halfmer/XIH6-Thermal-Camera/Lepton驱动参考/hardware/LeptonMicroBreakout/PureThermal_Micro_BoB.step

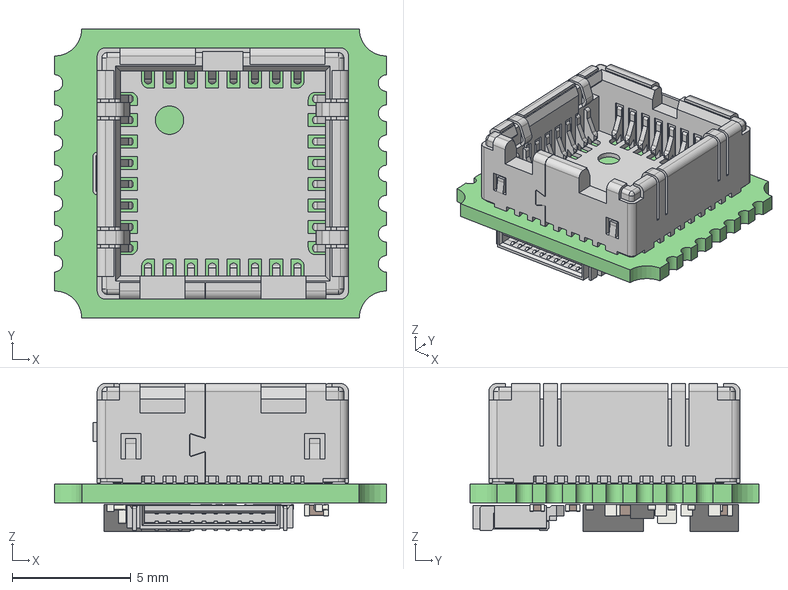
[picture p7: CAD file, 2026-07-07]
Lepton驱动参考/hardware/LeptonMicroBreakout/PureThermal_Micro_BoB.step
14.0 x 12.2 x 6.25 mm
_autosave-PureThermal_BoB_Mini PCB
