halfmer/XIH6-Thermal-Camera/MDK-ARM/build_log.txt

*** Using Compiler 'V6.24', folder: 'E:\keil_v5\ARM\ARMCLANG\Bin'
Build target 'XIH6_V2'
compiling main.c...
compiling lepton.c...
linking...
Program Size: Code=66718 RO-data=8478 RW-data=40 ZI-data=54088  
FromELF: creating hex file...
"XIH6_V2\XIH6_V2.axf" - 0 Error(s), 0 Warning(s).
Build Time Elapsed:  00:00:02
