halfmer/XIH6-Thermal-Camera/Core/Src/main.c

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
/* Includes ------------------------------------------------------------------*/
#include "main.h"
#include "adc.h"
#include "dma.h"
#include "i2c.h"
#include "ltdc.h"
#include "sdmmc.h"
#include "spi.h"
#include "usart.h"
#include "gpio.h"

/* USER CODE BEGIN Includes */
#include "LED.h"
#include "DELAY.h"
#include "oled.h"
#include "SHT40.h"
#include "SD_Card.h"
#include "string.h"
#include "lepton.h"
#include "lepton_stream.h"
#include "fire_guard.h"

/* USER CODE END Includes */

/* USER CODE BEGIN PTD */
/* Background time-wheel entry: period-gated cooperative task. The video
   path deliberately stays OUT of the wheel (README_14 §3). */
typedef struct {
    uint32_t period_ms;
    uint32_t last;
    void   (*fn)(void);
} App_WheelTask_t;
/* USER CODE END PTD */

/* USER CODE BEGIN PD */
#define SD_TEST_SECTOR   0x10000UL   /* scratch LBA used by the R/W self-test */
/* USER CODE END PD */


/* USER CODE BEGIN PV */
float temperature = 0.0f;
float humidity = 0.0f;
uint8_t sht40_status = 0;
char disp_buff[32]; //

/* SD card state */
uint8_t sd_init_status = SD_NOT_PRESENT;
uint8_t sd_present_last = 0xFF;          /* 0xFF forces a first-pass refresh */
HAL_SD_CardInfoTypeDef sd_info;
/* USER CODE END PV */

void SystemClock_Config(void);
void PeriphCommonClock_Config(void);
static void MPU_Config(void);
/* USER CODE BEGIN PFP */
static void SD_UART_Print(const char *s);
static void SD_ReportStatus(void);
static uint8_t SD_SelfTest(uint32_t sector);
static void LEP_PrintVoSPIDiag(const char *tag);
static void App_Task_Fire(void);
static void App_Task_Oled(void);
static void App_Task_Sht40(void);
static void App_Task_SdCd(void);
/* USER CODE END PFP */

/* USER CODE BEGIN 0 */
    unsigned char s_buf[]="It's mygo!!!!!\r\n";

static void LEP_PrintVoSPIDiag(const char *tag)
{
    char vd[448];

    sprintf(vd, "[LEP] VoSPI %s reason=%u reads=%lu valid=%lu discard=%lu invalid=%lu pkt0=%lu desync=%lu badseg=%lu spierr=%lu stale=%u mask=0x%02X seen=%u/%u/%u/%u segs=%u/%u/%u/%u dup=%u bad0=%u badx=%u wait=%u exp=%u last=%02X %02X %02X %02X seg=0x%02X\r\n",
            tag,
            (unsigned)lepton_diag.vospi_fail_reason,
            (unsigned long)lepton_diag.vospi_reads,
            (unsigned long)lepton_diag.vospi_valid,
            (unsigned long)lepton_diag.vospi_discard,
            (unsigned long)lepton_diag.vospi_invalid,
            (unsigned long)lepton_diag.vospi_pkt0,
            (unsigned long)lepton_diag.vospi_desync,
            (unsigned long)lepton_diag.vospi_bad_seg,
            (unsigned long)lepton_diag.vospi_spi_err,
            (unsigned)lepton_diag.vospi_stale_block,
            (unsigned)lepton_diag.vospi_got_mask,
            (unsigned)lepton_diag.vospi_seg_seen[1],
            (unsigned)lepton_diag.vospi_seg_seen[2],
            (unsigned)lepton_diag.vospi_seg_seen[3],
            (unsigned)lepton_diag.vospi_seg_seen[4],
            (unsigned)lepton_diag.vospi_seg_ok[1],
            (unsigned)lepton_diag.vospi_seg_ok[2],
            (unsigned)lepton_diag.vospi_seg_ok[3],
            (unsigned)lepton_diag.vospi_seg_ok[4],
            (unsigned)lepton_diag.vospi_dup_seg,
            (unsigned)lepton_diag.vospi_seg_bad0,
            (unsigned)lepton_diag.vospi_seg_badx,
            (unsigned)lepton_diag.vospi_sync_waits,
            (unsigned)lepton_diag.vospi_last_expected,
            (unsigned)lepton_diag.vospi_last_id0,
            (unsigned)lepton_diag.vospi_last_id1,
            (unsigned)lepton_diag.vospi_last_crc0,
            (unsigned)lepton_diag.vospi_last_crc1,
            (unsigned)lepton_diag.vospi_last_seg);
    SD_UART_Print(vd);
}
/* USER CODE END 0 */

/**
  * @brief  The application entry point.
  * @retval int
  */
int main(void)
{

  /* USER CODE BEGIN 1 */
  uint32_t test_count = 0;
  /* USER CODE END 1 */

  /* MPU Configuration--------------------------------------------------------*/
  MPU_Config();

  /* MCU Configuration--------------------------------------------------------*/

  /* Reset of all peripherals, Initializes the Flash interface and the Systick. */
  HAL_Init();

  /* Configure the system clock */
  SystemClock_Config();

  /* Configure the peripherals common clocks */
  PeriphCommonClock_Config();

  /* Initialize all configured peripherals */
  MX_GPIO_Init();
  MX_DMA_Init();
  MX_USART1_UART_Init();
  MX_SDMMC2_SD_Init();
  MX_I2C4_Init();
  MX_SPI4_Init();
  MX_ADC1_Init();
  MX_ADC2_Init();
  MX_LTDC_Init();
  MX_SPI5_Init();
  MX_UART4_Init();
  MX_UART5_Init();
  /* USER CODE BEGIN 2 */
  /* CH340C link (UART4 @ PA0/PA1, TX/RX swapped in CR2) -> 1.5Mbps.
     Carries only the binary thermal stream; host sends 'S'/'P'. */
  Lepton_Stream_Init(&huart4);

  /* Buzzer silent on request. New HW: PG9 -> 1k -> NPN base (10k base-emitter),
     emitter=GND, collector=buzzer(-), buzzer(+)=VCC. Active-HIGH low-side drive:
     PG9 HIGH = transistor ON = sound; PG9 LOW = OFF = silent. */
  HAL_GPIO_WritePin(BEEP_GPIO_GPIO_Port, BEEP_GPIO_Pin, GPIO_PIN_RESET);

  SW_I2C_Init();
  OLED_Init();

  OLED_Clear();
  OLED_ShowString(0, 0, (uint8_t *)"G:----- A:-----   ", 12, 1);

  OLED_ShowString(0, 16, (uint8_t *)"Temp: ", 16, 1);
  OLED_ShowString(0, 32, (uint8_t *)"Humi: ", 16, 1);

  FireGuard_Init();


  HAL_UART_Transmit(&huart1, s_buf, (uint16_t)strlen((char *)s_buf), 100);

  /* ---- Reset-cause banner. If inserting the SD card makes THIS line re-print
     with POR/BOR/PIN set, the "freeze" is really a brownout/reset on insertion
     (a power-integrity hardware fault), NOT a software hang in HAL_SD_Init. ---- */
  {
      char rb[96];
      uint32_t rsr = RCC->RSR;
      sprintf(rb, "\r\n[RST] RSR=0x%08lX POR=%u BOR=%u PIN=%u SFT=%u IWDG=%u LPWR=%u\r\n",
              (unsigned long)rsr,
              (unsigned)((rsr >> 23) & 1U),   /* PORRSTF  */
              (unsigned)((rsr >> 21) & 1U),   /* BORRSTF  */
              (unsigned)((rsr >> 22) & 1U),   /* PINRSTF  */
              (unsigned)((rsr >> 24) & 1U),   /* SFTRSTF  */
              (unsigned)((rsr >> 26) & 1U),   /* IWDG1RSTF*/
              (unsigned)((rsr >> 30) & 1U));  /* LPWRRSTF */
      HAL_UART_Transmit(&huart1, (uint8_t *)rb, (uint16_t)strlen(rb), 100);
      __HAL_RCC_CLEAR_RESET_FLAGS();
  }

  SD_UART_Print("[STREAM] UART4/CH340 1.5Mbps binary only: 'S' = start thermal stream, 'P' = stop; debug logs on USART1 @115200\r\n");

  /* ---- SD card bring-up + read/write self-test ---- */
  if (SD_IsPresent() != SD_OK)
  {
      sd_present_last = 0;
      sd_init_status  = SD_NOT_PRESENT;
      OLED_ShowString(32, 48, (uint8_t *)"No Card ", 16, 1);
      SD_UART_Print("\r\n[SD] no card in slot\r\n");
  }
  else
  {
      sd_present_last = 1;
      sd_init_status  = SD_Card_Init();
      SD_ReportStatus();
      if (sd_init_status == SD_OK)
      {
          if (SD_SelfTest(SD_TEST_SECTOR) == SD_OK)
              SD_UART_Print("[SD] R/W self-test PASS\r\n");
          else
              SD_UART_Print("[SD] R/W self-test FAIL\r\n");
      }
  }

  /* ---- Lepton 3.5 thermal camera bring-up (VoSPI@SPI4, CCI@I2C4) ----
     Reconfigures PA8 as TIM1_CH1 ~24MHz and SPI4 (mode 3/8-bit/7.5MHz/soft-CS on PE4).
     Releases RESET_L(PJ3)/PWR_DWN_L(PH6) (CubeMX holds them asserted at boot),
     waits ~950ms boot, then enables radiometric TLinear over CCI. */
  Lepton_Init(&hspi4, &hi2c4);
  {
      char lbuf[320];
      char cci_boot = lepton_diag.last_i2c_ok ? (lepton_diag.booted ? '1' : '0') : '?';
      sprintf(lbuf, "[LEP] mclk=%u mclk_hz=%lu sys=%lu pclk2=%lu pwr=%u rst=%u rstIDR=%u pwdnIDR=%u i2c_rdy=%u cci=%s cci_boot=%c(%lums) status_ok=%u status=0x%04X tlin=%d\r\n",
              (unsigned)lepton_diag.mclk_on,
              (unsigned long)lepton_diag.mclk_hz,
              (unsigned long)lepton_diag.sysclk_hz,
              (unsigned long)lepton_diag.pclk2_hz,
              (unsigned)lepton_diag.powered,
              (unsigned)lepton_diag.reset_released, (unsigned)lepton_diag.rst_readback,
              (unsigned)lepton_diag.pwdn_readback, (unsigned)lepton_diag.i2c_ready,
              lepton_diag.cci_transport ? "BB" : "HAL",
              cci_boot, (unsigned long)lepton_diag.boot_wait_ms,
              (unsigned)lepton_diag.last_i2c_ok, (unsigned)lepton_diag.status_reg,
              (int)lepton_diag.tlinear_err);
      SD_UART_Print(lbuf);
      if (!lepton_diag.rst_readback)
          SD_UART_Print("[LEP] RESET_L(PJ3) reads LOW after release -> net held low (short/pulldown/HW), Lepton stuck in reset\r\n");
      else if (!lepton_diag.i2c_ready)
      {
          char ib[200];
          sprintf(ib, "[LEP] HAL I2C4 no ACK @0x2A: err=0x%lX isr=0x%lX SCLidle=%u SDAidle=%u scan_first=0x%02X scan_cnt=%u\r\n",
                  (unsigned long)lepton_diag.i2c_err, (unsigned long)lepton_diag.i2c_isr,
                  (unsigned)lepton_diag.scl_idle, (unsigned)lepton_diag.sda_idle,
                  (unsigned)lepton_diag.i2c_scan_first, (unsigned)lepton_diag.i2c_scan_count);
          SD_UART_Print(ib);
          if (!lepton_diag.last_i2c_ok)
              SD_UART_Print("[LEP] CCI status unread -> cci_boot is UNKNOWN; shutter/FFC motion still means the Lepton core likely booted\r\n");
          if (!lepton_diag.scl_idle || !lepton_diag.sda_idle)
              SD_UART_Print("[LEP] I2C line STUCK LOW at idle -> no pull-up / short to GND / VDDIO off / wrong pin. Fix wiring first.\r\n");
          else if (lepton_diag.i2c_scan_count == 0)
              /* NOTE: HAL_I2C_IsDeviceReady returns err=0x20(TIMEOUT) for a plain
                 no-ACK too (it clears AF each trial and ORs TIMEOUT at the end), so
                 0x20 alone does NOT prove a clock/peripheral fault. Lines idle-high
                 + 0 devices = nobody answers on an electrically-OK bus. The bit-bang
                 result below is the decisive config-vs-hardware test. */
              SD_UART_Print("[LEP] lines high but 0 devices -> see bit-bang test below (Lepton VDDIO 2.8V? pull-ups? SDA/SCL swap?)\r\n");
          else if (lepton_diag.i2c_scan_first != 0x2A)
              SD_UART_Print("[LEP] I2C alive but Lepton not at 0x2A -> likely SDA/SCL swapped or wrong module pins\r\n");

          /* DECISIVE config-vs-hardware test: SW_I2C-style open-drain GPIO on
             PD12/PD13, bypassing the STM32 I2C4 peripheral entirely. */
          {
              char bb[192];
              sprintf(bb, "[LEP] SW-OD I2C (SW_I2C-style, bypasses I2C4): ack@0x2A=%u scan_first=0x%02X scan_cnt=%u\r\n",
                      (unsigned)lepton_diag.bb_ack_2a,
                      (unsigned)lepton_diag.bb_scan_first,
                      (unsigned)lepton_diag.bb_scan_count);
              SD_UART_Print(bb);

              /* Second bit-bang pass with SCL/SDA roles SWAPPED (SCL=PD13,
                 SDA=PD12). If this pass ACKs where the normal pass did not, the
                 two lines are physically swapped -> just re-wire, no scope. */
              {
                  char sw[160];
                  sprintf(sw, "[LEP] bit-bang SWAPPED (SCL=PD13,SDA=PD12): ack@0x2A=%u scan_first=0x%02X scan_cnt=%u\r\n",
                          (unsigned)lepton_diag.bb_swap_ack,
                          (unsigned)lepton_diag.bb_swap_first,
                          (unsigned)lepton_diag.bb_swap_count);
                  SD_UART_Print(sw);
              }

              if (lepton_diag.bb_ack_2a)
                  SD_UART_Print("[LEP] >>> bit-bang ACKs @0x2A but HAL did NOT -> using software CCI fallback; I2C4 timing/config remains suspect\r\n");
              else if (lepton_diag.bb_swap_ack)
                  SD_UART_Print("[LEP] >>> SWAPPED pass ACKs @0x2A -> SDA/SCL ARE PHYSICALLY SWAPPED. Swap PD12<->PD13 wiring.\r\n");
              else if (lepton_diag.bb_scan_count > 0 || lepton_diag.bb_swap_count > 0)
                  SD_UART_Print("[LEP] >>> bit-bang finds device NOT at 0x2A -> wrong address / partial swap (HW alive)\r\n");
              else
                  SD_UART_Print("[LEP] >>> normal+swapped bit-bang both 0 devices -> not an I2C4 peripheral issue; check CCI pad power/level/timing or module state\r\n");
          }
      }
      else if (!lepton_diag.last_i2c_ok)
          SD_UART_Print("[LEP] I2C ACKed once but STATUS read failed -> CCI register phase/timing still suspect\r\n");
      else if (!lepton_diag.booted)
          SD_UART_Print("[LEP] CCI STATUS readable but boot bit is 0 -> check MCLK ~24MHz clean / reset timing\r\n");
  }
  /* USER CODE END 2 */

  /* Infinite loop */
  /* USER CODE BEGIN WHILE */
  while (1)
  {
    /* USER CODE END WHILE */

    /* USER CODE BEGIN 3 */

    /* --------------------------------------------------------------------
     * Cooperative super-loop ("pseudo-concurrent", no RTOS):
     *   - the LEPTON video pipeline runs every iteration (stream mode) or
     *     on its idle test cadence;
     *   - every other peripheral gets a tick-gated SLICE that runs in BOTH
     *     modes. Each slice is short (µs..10ms) and touches only its own
     *     peripheral, so nothing can starve or corrupt the video path.
     *   Red line: no USART1 prints from slices while a TX DMA may be in
     *   flight (README_9 Step9A) - slices below only use OLED (SW_I2C),
     *   ADC1/2 and GPIO, none of which are shared with the stream.
     * ------------------------------------------------------------------ */

    Lepton_Stream_Poll();

    /* ---- slice 0: LEPTON video (the priority customer) ---- */
    if (Lepton_Stream_Active())
    {
        if (Lepton_Capture_Frame())
        {
            Lepton_Stream_SendFrame();
            /* scan AFTER arming the TX DMA: the ~100µs hot-spot sweep runs
               in parallel with the transfer, video latency unchanged */
            FireGuard_ThermalScan();
        }
        else
            Lepton_VoSPI_Resync();
        LED_TURN(1);              /* 2ms heartbeat vs ~256ms per frame */
    }
    else
    {
        LED_TURN(250);
        test_count++;

        /* idle-mode Lepton health check every ~16 loops (~8s) */
        if ((test_count % 16U) == 0U)
        {
            if (Lepton_Capture_Frame())
            {
                char lp[48];
                uint16_t craw = lepton_raw_frame[60][80];   /* centre pixel */
                float    ctmp = Lepton_Raw_To_Temp(craw);
                FireGuard_ThermalScan();   /* idle mode: 8s cadence, still guarded */
                sprintf(lp, "[LEP] OK c_raw=%u c=%.2fC\r\n", (unsigned)craw, ctmp);
                SD_UART_Print(lp);
                LEP_PrintVoSPIDiag("okdiag");
            }
            else
            {
                SD_UART_Print("[LEP] no frame (check MCLK/VoSPI); resync\r\n");
                LEP_PrintVoSPIDiag("diag");
                Lepton_VoSPI_Resync();
            }
        }
    }

    /* ---- slice 1..N: background time wheel (runs in BOTH modes) ----
       Unlike the README_10 attempt, the VIDEO PATH IS NOT IN THE WHEEL -
       it runs unconditionally above; the wheel only paces the cheap,
       resource-exclusive background tasks. SHT40 is self-gated (called
       every loop, not from the wheel) because its 10ms conversion wait
       must be spread across iterations, not blocked in one wheel slot. */
    App_Task_Sht40();
    {
        static App_WheelTask_t wheel[] = {
            { 0U,    0U, App_Task_Fire  },   /* self-gated 200ms inside */
            { 500U,  0U, App_Task_Oled  },   /* gas readout line        */
            { 1000U, 0U, App_Task_SdCd  },   /* SD hot-plug edge        */
        };
        uint32_t now = HAL_GetTick();
        for (uint32_t ti = 0; ti < (sizeof(wheel) / sizeof(wheel[0])); ti++)
        {
            if ((now - wheel[ti].last) >= wheel[ti].period_ms)
            {
                wheel[ti].last = now;
                wheel[ti].fn();
            }
        }
    }

  }
  /* USER CODE END 3 */
}

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
/* USER CODE BEGIN 4 */

/* Blocking debug print on USART1 @115200. UART4/CH340 is kept binary-only for
   the thermal stream, so text can never land inside host image frames. */
static void SD_UART_Print(const char *s)
{
    HAL_UART_Transmit(&huart1, (uint8_t *)s, (uint16_t)strlen(s), 100);
}

/* ---- background time-wheel tasks (README_14): each touches ONLY its own
   peripheral (ADC1/2, SW_I2C OLED, SHT40 I2C, PG10 GPIO) - zero overlap with
   the video path, zero USART1 prints in the periodic path (Step9A rule). ---- */

static void App_Task_Fire(void)
{
    FireGuard_Poll();               /* self-gated to FIRE_GUARD_PERIOD_MS */
}

static void App_Task_Oled(void)
{
    switch (FireGuard_State())
    {
    case FIRE_STATE_WARMUP:
    {
        uint32_t now = HAL_GetTick();
        uint32_t left = (now < FIRE_WARMUP_MS) ? ((FIRE_WARMUP_MS - now) / 1000UL) : 0UL;
        sprintf(disp_buff, "MQ PREHEAT %2lus     ", (unsigned long)left);
        break;
    }
    case FIRE_STATE_CALIB:
        sprintf(disp_buff, "MQ CAL(clean air)  ");
        break;
    default:
        sprintf(disp_buff, "G%4uppm A%4u %s",
                (unsigned)FireGuard_MQ2_PPM(),
                (unsigned)FireGuard_MQ135_PPM(),
                (FireGuard_Alarm() || FireGuard_ThermalAlarm()) ? "FIRE" : "    ");
        break;
    }
    OLED_ShowString(0, 0, (uint8_t *)disp_buff, 12, 1);
}

static void App_Task_Sht40(void)
{
    /* Self-gated (not wheel-paced): sht40_request/poll split the 10ms
       conversion wait across loop iterations so VoSPI is never delayed.
       2s cadence between measurements. */
    static uint32_t next_start = 0;
    uint32_t now = HAL_GetTick();

    uint8_t st = sht40_poll(&temperature, &humidity);
    if (st == 0xFF) return;             /* still converting */
    if (st == 0)
    {
        sprintf(disp_buff, "%.2f C   ", temperature);
        OLED_ShowString(48, 16, (uint8_t *)disp_buff, 16, 1);
        sprintf(disp_buff, "%.2f %%   ", humidity);
        OLED_ShowString(48, 32, (uint8_t *)disp_buff, 16, 1);
        next_start = now + 2000U;
    }
    else if (st == 0xFE)
    {
        /* idle: start a new measurement on cadence */
        if (now >= next_start)
            (void)sht40_request(&temperature, &humidity);
    }
    else
    {
        sht40_status = st;
        next_start = now + 2000U;        /* retry after cooldown */
    }
}

static void App_Task_SdCd(void)
{
    uint8_t present_now = (SD_IsPresent() == SD_OK) ? 1 : 0;
    if (present_now != sd_present_last)
    {
        sd_present_last = present_now;
        if (present_now)
        {
            sd_init_status = SD_Card_Init();
            SD_ReportStatus();
        }
        else
        {
            sd_init_status = SD_NOT_PRESENT;
            OLED_ShowString(32, 48, (uint8_t *)"No Card ", 16, 1);
        }
    }
}

/* Show SD status on OLED + UART (capacity in MB when OK). */
static void SD_ReportStatus(void)
{
    if (sd_init_status == SD_OK)
    {
        uint32_t cap_mb;
        SD_GetCardInfo(&sd_info);
        cap_mb = (uint32_t)(((uint64_t)sd_info.BlockNbr * sd_info.BlockSize) >> 20);
        sprintf(disp_buff, "%luMB    ", (unsigned long)cap_mb);
        OLED_ShowString(32, 48, (uint8_t *)disp_buff, 16, 1);
        sprintf(disp_buff, "[SD] init OK, %lu MB\r\n", (unsigned long)cap_mb);
        SD_UART_Print(disp_buff);
    }
    else if (sd_init_status == SD_NOT_PRESENT)
    {
        OLED_ShowString(32, 48, (uint8_t *)"No Card ", 16, 1);
        SD_UART_Print("[SD] not present\r\n");
    }
    else
    {
        char dbg[96];
        OLED_ShowString(32, 48, (uint8_t *)"Init Err", 16, 1);
        sprintf(dbg, "[SD] init FAILED stage=%u err=0x%08lX kerclk=%lu Hz cardver=%u\r\n",
                (unsigned)sd_dbg_stage, (unsigned long)sd_dbg_errorcode,
                (unsigned long)sd_dbg_kerclk, (unsigned)sd_dbg_cardver);
        SD_UART_Print(dbg);
    }
}

/* Write a known pattern to one sector, read it back, compare. */
static uint8_t SD_SelfTest(uint32_t sector)
{
    static uint8_t wbuf[512];
    static uint8_t rbuf[512];
    uint32_t i;

    for (i = 0; i < 512; i++) wbuf[i] = (uint8_t)(i ^ 0xA5);

    if (SD_WriteDisk_DMA(wbuf, sector, 1) != SD_OK) return SD_ERROR;
    memset(rbuf, 0, sizeof(rbuf));
    if (SD_ReadDisk_DMA(rbuf, sector, 1) != SD_OK) return SD_ERROR;

    return (memcmp(wbuf, rbuf, 512) == 0) ? SD_OK : SD_ERROR;
}

/* USER CODE END 4 */

 /* MPU Configuration */

void MPU_Config(void)
{
  MPU_Region_InitTypeDef MPU_InitStruct = {0};

  /* Disables the MPU */
  HAL_MPU_Disable();

  /** Initializes and configures the Region and the memory to be protected
  */
  MPU_InitStruct.Enable = MPU_REGION_ENABLE;
  MPU_InitStruct.Number = MPU_REGION_NUMBER0;
  MPU_InitStruct.BaseAddress = 0x0;
  MPU_InitStruct.Size = MPU_REGION_SIZE_4GB;
  MPU_InitStruct.SubRegionDisable = 0x87;
  MPU_InitStruct.TypeExtField = MPU_TEX_LEVEL0;
  MPU_InitStruct.AccessPermission = MPU_REGION_NO_ACCESS;
  MPU_InitStruct.DisableExec = MPU_INSTRUCTION_ACCESS_DISABLE;
  MPU_InitStruct.IsShareable = MPU_ACCESS_SHAREABLE;
  MPU_InitStruct.IsCacheable = MPU_ACCESS_NOT_CACHEABLE;
  MPU_InitStruct.IsBufferable = MPU_ACCESS_NOT_BUFFERABLE;

  
  HAL_MPU_ConfigRegion(&MPU_InitStruct);
  /* Enables the MPU */
  HAL_MPU_Enable(MPU_PRIVILEGED_DEFAULT);

}

/**
  * @brief  This function is executed in case of error occurrence.
  * @retval None
  */
void Error_Handler(void)
{
  /* USER CODE BEGIN Error_Handler_Debug */
  /* User can add his own implementation to report the HAL error return state */
  __disable_irq();
  while (1)
  {
  }
  /* USER CODE END Error_Handler_Debug */
}
#ifdef USE_FULL_ASSERT
/**
  * @brief  Reports the name of the source file and the source line number
  *         where the assert_param error has occurred.
  * @param  file: pointer to the source file name
  * @param  line: assert_param error line source number
  * @retval None
  */
void assert_failed(uint8_t *file, uint32_t line)
{
  /* USER CODE BEGIN 6 */
  /* User can add his own implementation to report the file name and line number,
     ex: printf("Wrong parameters value: file %s on line %d\r\n", file, line) */
  /* USER CODE END 6 */
}
#endif /* USE_FULL_ASSERT */
