halfmer/XIH6-Thermal-Camera/Drivers/PER/LCD/lcd_ex.c

/**
 ****************************************************************************************************
 * @file        lcd_ex.c
 * @author      正点原子团队(ALIENTEK)
 * @version     V1.0
 * @date        2023-06-12
 * @brief       LCD驱动代码
 * @license     Copyright (c) 2020-2032, 广州市星翼电子科技有限公司
 ****************************************************************************************************
 * @attention
 * 
 * 实验平台:正点原子 北极星 H750开发板
 * 在线视频:www.yuanzige.com
 * 技术论坛:www.openedv.com
 * 公司网址:www.alientek.com
 * 购买地址:openedv.taobao.com
 * 
 ****************************************************************************************************
 */

#include "./SYSTEM/delay/delay.h"
#include "./BSP/LCD/lcd.h"

/**
 * @brief       ST7789寄存器初始化
 * @param       无
 * @retval      无
 */
void lcd_ex_st7789_reginit(void)
{
    lcd_wr_regno(0x11);
    delay_ms(120);
    lcd_wr_regno(0x36);
    lcd_wr_data(0x00);
    lcd_wr_regno(0x3A);
    lcd_wr_data(0x05);
    lcd_wr_regno(0xB2);
    lcd_wr_data(0x0C);
    lcd_wr_data(0x0C);
    lcd_wr_data(0x00);
    lcd_wr_data(0x33);
    lcd_wr_data(0x33);
    lcd_wr_regno(0xB7);
    lcd_wr_data(0x35);
    lcd_wr_regno(0xBB);
    lcd_wr_data(0x32);
    lcd_wr_regno(0xC0);
    lcd_wr_data(0x0C);
    lcd_wr_regno(0xC2);
    lcd_wr_data(0x01);
    lcd_wr_regno(0xC3);
    lcd_wr_data(0x10);
    lcd_wr_regno(0xC4);
    lcd_wr_data(0x20);
    lcd_wr_regno(0xC6);
    lcd_wr_data(0x0F);
    lcd_wr_regno(0xD0);
    lcd_wr_data(0xA4);
    lcd_wr_data(0xA1);
    lcd_wr_regno(0xE0);
    lcd_wr_data(0xD0);
    lcd_wr_data(0x00);
    lcd_wr_data(0x02);
    lcd_wr_data(0x07);
    lcd_wr_data(0x0A);
    lcd_wr_data(0x28);
    lcd_wr_data(0x32);
    lcd_wr_data(0x44);
    lcd_wr_data(0x42);
    lcd_wr_data(0x06);
    lcd_wr_data(0x0E);
    lcd_wr_data(0x12);
    lcd_wr_data(0x14);
    lcd_wr_data(0x17);
    lcd_wr_regno(0xE1);
    lcd_wr_data(0xd0);
    lcd_wr_data(0x00);
    lcd_wr_data(0x02);
    lcd_wr_data(0x07);
    lcd_wr_data(0x0A);
    lcd_wr_data(0x28);
    lcd_wr_data(0x31);
    lcd_wr_data(0x54);
    lcd_wr_data(0x47);
    lcd_wr_data(0x0E);
    lcd_wr_data(0x1C);
    lcd_wr_data(0x17);
    lcd_wr_data(0x1B);
    lcd_wr_data(0x1E);
    lcd_wr_regno(0x2A);
    lcd_wr_data(0x00);
    lcd_wr_data(0x00);
    lcd_wr_data(0x00);
    lcd_wr_data(0xEF);
    lcd_wr_regno(0x2B);
    lcd_wr_data(0x00);
    lcd_wr_data(0x00);
    lcd_wr_data(0x01);
    lcd_wr_data(0x3F);
    lcd_wr_regno(0x29);
}

/**
 * @brief       ILI9341寄存器初始化
 * @param       无
 * @retval      无
 */
void lcd_ex_ili9341_reginit(void)
{
    lcd_wr_regno(0xCF);
    lcd_wr_data(0x00);
    lcd_wr_data(0xC1);
    lcd_wr_data(0x30);
    lcd_wr_regno(0xED);
    lcd_wr_data(0x64);
    lcd_wr_data(0x03);
    lcd_wr_data(0x12);
    lcd_wr_data(0x81);
    lcd_wr_regno(0xE8);
    lcd_wr_data(0x85);
    lcd_wr_data(0x10);
    lcd_wr_data(0x7A);
    lcd_wr_regno(0xCB);
    lcd_wr_data(0x39);
    lcd_wr_data(0x2C);
    lcd_wr_data(0x00);
    lcd_wr_data(0x34);
    lcd_wr_data(0x02);
    lcd_wr_regno(0xF7);
    lcd_wr_data(0x20);
    lcd_wr_regno(0xEA);
    lcd_wr_data(0x00);
    lcd_wr_data(0x00);
    lcd_wr_regno(0xC0);
    lcd_wr_data(0x1B);
    lcd_wr_regno(0xC1);
    lcd_wr_data(0x01);
    lcd_wr_regno(0xC5);
    lcd_wr_data(0x30);
    lcd_wr_data(0x30);
    lcd_wr_regno(0xC7);
    lcd_wr_data(0xB7);
    lcd_wr_regno(0x36);
    lcd_wr_data(0x48);
    lcd_wr_regno(0x3A);
    lcd_wr_data(0x55);
    lcd_wr_regno(0xB1);
    lcd_wr_data(0x00);
    lcd_wr_data(0x1A);
    lcd_wr_regno(0xB6);
    lcd_wr_data(0x0A);
    lcd_wr_data(0xA2);
    lcd_wr_regno(0xF2);
    lcd_wr_data(0x00);
    lcd_wr_regno(0x26);
    lcd_wr_data(0x01);
    lcd_wr_regno(0xE0);
    lcd_wr_data(0x0F);
    lcd_wr_data(0x2A);
    lcd_wr_data(0x28);
    lcd_wr_data(0x08);
    lcd_wr_data(0x0E);
    lcd_wr_data(0x08);
    lcd_wr_data(0x54);
    lcd_wr_data(0xA9);
    lcd_wr_data(0x43);
    lcd_wr_data(0x0A);
    lcd_wr_data(0x0F);
    lcd_wr_data(0x00);
    lcd_wr_data(0x00);
    lcd_wr_data(0x00);
    lcd_wr_data(0x00);
    lcd_wr_regno(0xE1);
    lcd_wr_data(0x00);
    lcd_wr_data(0x15);
    lcd_wr_data(0x17);
    lcd_wr_data(0x07);
    lcd_wr_data(0x11);
    lcd_wr_data(0x06);
    lcd_wr_data(0x2B);
    lcd_wr_data(0x56);
    lcd_wr_data(0x3C);
    lcd_wr_data(0x05);
    lcd_wr_data(0x10);
    lcd_wr_data(0x0F);
    lcd_wr_data(0x3F);
    lcd_wr_data(0x3F);
    lcd_wr_data(0x0F);
    lcd_wr_regno(0x2B);
    lcd_wr_data(0x00);
    lcd_wr_data(0x00);
    lcd_wr_data(0x01);
    lcd_wr_data(0x3F);
    lcd_wr_regno(0x2A);
    lcd_wr_data(0x00);
    lcd_wr_data(0x00);
    lcd_wr_data(0x00);
    lcd_wr_data(0xEF);
    lcd_wr_regno(0x11);
    delay_ms(120);
    lcd_wr_regno(0x29);
}

/**
 * @brief       NT35310寄存器初始化
 * @param       无
 * @retval      无
 */
void lcd_ex_nt35310_reginit(void)
{
    lcd_wr_regno(0xED);
    lcd_wr_data(0x01);
    lcd_wr_data(0xFE);
    lcd_wr_regno(0xEE);
    lcd_wr_data(0xDE);
    lcd_wr_data(0x21);
    lcd_wr_regno(0xF1);
    lcd_wr_data(0x01);
    lcd_wr_regno(0xDF);
    lcd_wr_data(0x10);
    lcd_wr_regno(0xC4);
    lcd_wr_data(0x8F);
    lcd_wr_regno(0xC6);
    lcd_wr_data(0x00);
    lcd_wr_data(0xE2);
    lcd_wr_data(0xE2);
    lcd_wr_data(0xE2);
    lcd_wr_regno(0xBF);
    lcd_wr_data(0xAA);
    lcd_wr_regno(0xB0);
    lcd_wr_data(0x0D);
    lcd_wr_data(0x00);
    lcd_wr_data(0x0D);
    lcd_wr_data(0x00);
    lcd_wr_data(0x11);
    lcd_wr_data(0x00);
    lcd_wr_data(0x19);
    lcd_wr_data(0x00);
    lcd_wr_data(0x21);
    lcd_wr_data(0x00);
    lcd_wr_data(0x2D);
    lcd_wr_data(0x00);
    lcd_wr_data(0x3D);
    lcd_wr_data(0x00);
    lcd_wr_data(0x5D);
    lcd_wr_data(0x00);
    lcd_wr_data(0x5D);
    lcd_wr_data(0x00);
    lcd_wr_regno(0xB1);
    lcd_wr_data(0x80);
    lcd_wr_data(0x00);
    lcd_wr_data(0x8B);
    lcd_wr_data(0x00);
    lcd_wr_data(0x96);
    lcd_wr_data(0x00);
    lcd_wr_regno(0xB2);
    lcd_wr_data(0x00);
    lcd_wr_data(0x00);
    lcd_wr_data(0x02);
    lcd_wr_data(0x00);
    lcd_wr_data(0x03);
    lcd_wr_data(0x00);
    lcd_wr_regno(0xB3);
    lcd_wr_data(0x00);
    lcd_wr_data(0x00);
    lcd_wr_data(0x00);
    lcd_wr_data(0x00);
    lcd_wr_data(0x00);
    lcd_wr_data(0x00);
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
    lcd_wr_data(0x26);
    lcd_wr_data(0x10);
    lcd_wr_data(0x12);
    lcd_wr_data(0x2C);
    lcd_wr_data(0x32);
    lcd_wr_regno(0xF0);
    lcd_wr_data(0x3C);
    lcd_wr_regno(0xF0);
    lcd_wr_data(0x69);
    delay_ms(120);
    lcd_wr_regno(0x21);
    lcd_wr_regno(0x29);
}

/**
 * @brief       NT35510寄存器初始化
 * @param       无
 * @retval      无
 */
void lcd_ex_nt35510_reginit(void)
{
    lcd_write_reg(0xF000, 0x55);
    lcd_write_reg(0xF001, 0xAA);
    lcd_write_reg(0xF002, 0x52);
    lcd_write_reg(0xF003, 0x08);
    lcd_write_reg(0xF004, 0x01);
    lcd_write_reg(0xB000, 0x0D);
    lcd_write_reg(0xB001, 0x0D);
    lcd_write_reg(0xB002, 0x0D);
    lcd_write_reg(0xB600, 0x34);
    lcd_write_reg(0xB601, 0x34);
    lcd_write_reg(0xB602, 0x34);
    lcd_write_reg(0xB100, 0x0D);
    lcd_write_reg(0xB101, 0x0D);
    lcd_write_reg(0xB102, 0x0D);
    lcd_write_reg(0xB700, 0x34);
    lcd_write_reg(0xB701, 0x34);
    lcd_write_reg(0xB702, 0x34);
    lcd_write_reg(0xB200, 0x00);
    lcd_write_reg(0xB201, 0x00);
    lcd_write_reg(0xB202, 0x00);
    lcd_write_reg(0xB800, 0x24);
    lcd_write_reg(0xB801, 0x24);
    lcd_write_reg(0xB802, 0x24);
    lcd_write_reg(0xBF00, 0x01);
    lcd_write_reg(0xB300, 0x0F);
    lcd_write_reg(0xB301, 0x0F);
    lcd_write_reg(0xB302, 0x0F);
    lcd_write_reg(0xB900, 0x34);
    lcd_write_reg(0xB901, 0x34);
    lcd_write_reg(0xB902, 0x34);
    lcd_write_reg(0xB500, 0x08);
    lcd_write_reg(0xB501, 0x08);
    lcd_write_reg(0xB502, 0x08);
    lcd_write_reg(0xC200, 0x03);
    lcd_write_reg(0xBA00, 0x24);
    lcd_write_reg(0xBA01, 0x24);
    lcd_write_reg(0xBA02, 0x24);
    lcd_write_reg(0xBC00, 0x00);
    lcd_write_reg(0xBC01, 0x78);
    lcd_write_reg(0xBC02, 0x00);
    lcd_write_reg(0xBD00, 0x00);
    lcd_write_reg(0xBD01, 0x78);
    lcd_write_reg(0xBD02, 0x00);
    lcd_write_reg(0xBE00, 0x00);
    lcd_write_reg(0xBE01, 0x64);
    lcd_write_reg(0xD100, 0x00);
    lcd_write_reg(0xD101, 0x33);
    lcd_write_reg(0xD102, 0x00);
    lcd_write_reg(0xD103, 0x34);
    lcd_write_reg(0xD104, 0x00);
    lcd_write_reg(0xD105, 0x3A);
    lcd_write_reg(0xD106, 0x00);
    lcd_write_reg(0xD107, 0x4A);
    lcd_write_reg(0xD108, 0x00);
    lcd_write_reg(0xD109, 0x5C);
    lcd_write_reg(0xD10A, 0x00);
    lcd_write_reg(0xD10B, 0x81);
    lcd_write_reg(0xD10C, 0x00);
    lcd_write_reg(0xD10D, 0xA6);
    lcd_write_reg(0xD10E, 0x00);
    lcd_write_reg(0xD10F, 0xE5);
    lcd_write_reg(0xD110, 0x01);
    lcd_write_reg(0xD111, 0x13);
    lcd_write_reg(0xD112, 0x01);
    lcd_write_reg(0xD113, 0x54);
    lcd_write_reg(0xD114, 0x01);
    lcd_write_reg(0xD115, 0x82);
    lcd_write_reg(0xD116, 0x01);
    lcd_write_reg(0xD117, 0xCA);
    lcd_write_reg(0xD118, 0x02);
    lcd_write_reg(0xD119, 0x00);
    lcd_write_reg(0xD11A, 0x02);
    lcd_write_reg(0xD11B, 0x01);
    lcd_write_reg(0xD11C, 0x02);
    lcd_write_reg(0xD11D, 0x34);
    lcd_write_reg(0xD11E, 0x02);
    lcd_write_reg(0xD11F, 0x67);
    lcd_write_reg(0xD120, 0x02);
    lcd_write_reg(0xD121, 0x84);
    lcd_write_reg(0xD122, 0x02);
    lcd_write_reg(0xD123, 0xA4);
    lcd_write_reg(0xD124, 0x02);
    lcd_write_reg(0xD125, 0xB7);
    lcd_write_reg(0xD126, 0x02);
    lcd_write_reg(0xD127, 0xCF);
    lcd_write_reg(0xD128, 0x02);
    lcd_write_reg(0xD129, 0xDE);
    lcd_write_reg(0xD12A, 0x02);
    lcd_write_reg(0xD12B, 0xF2);
    lcd_write_reg(0xD12C, 0x02);
    lcd_write_reg(0xD12D, 0xFE);
    lcd_write_reg(0xD12E, 0x03);
    lcd_write_reg(0xD12F, 0x10);
    lcd_write_reg(0xD130, 0x03);
    lcd_write_reg(0xD131, 0x33);
    lcd_write_reg(0xD132, 0x03);
    lcd_write_reg(0xD133, 0x6D);
    lcd_write_reg(0xD200, 0x00);
    lcd_write_reg(0xD201, 0x33);
    lcd_write_reg(0xD202, 0x00);
    lcd_write_reg(0xD203, 0x34);
    lcd_write_reg(0xD204, 0x00);
    lcd_write_reg(0xD205, 0x3A);
    lcd_write_reg(0xD206, 0x00);
    lcd_write_reg(0xD207, 0x4A);
    lcd_write_reg(0xD208, 0x00);
    lcd_write_reg(0xD209, 0x5C);
    lcd_write_reg(0xD20A, 0x00);
    lcd_write_reg(0xD20B, 0x81);
    lcd_write_reg(0xD20C, 0x00);
    lcd_write_reg(0xD20D, 0xA6);
    lcd_write_reg(0xD20E, 0x00);
    lcd_write_reg(0xD20F, 0xE5);
    lcd_write_reg(0xD210, 0x01);
    lcd_write_reg(0xD211, 0x13);
    lcd_write_reg(0xD212, 0x01);
    lcd_write_reg(0xD213, 0x54);
    lcd_write_reg(0xD214, 0x01);
    lcd_write_reg(0xD215, 0x82);
    lcd_write_reg(0xD216, 0x01);
    lcd_write_reg(0xD217, 0xCA);
    lcd_write_reg(0xD218, 0x02);
    lcd_write_reg(0xD219, 0x00);
    lcd_write_reg(0xD21A, 0x02);
    lcd_write_reg(0xD21B, 0x01);
    lcd_write_reg(0xD21C, 0x02);
    lcd_write_reg(0xD21D, 0x34);
    lcd_write_reg(0xD21E, 0x02);
    lcd_write_reg(0xD21F, 0x67);
    lcd_write_reg(0xD220, 0x02);
    lcd_write_reg(0xD221, 0x84);
    lcd_write_reg(0xD222, 0x02);
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
    lcd_write_reg(0xD62B, 0xF2);
    lcd_write_reg(0xD62C, 0x02);
    lcd_write_reg(0xD62D, 0xFE);
    lcd_write_reg(0xD62E, 0x03);
    lcd_write_reg(0xD62F, 0x10);
    lcd_write_reg(0xD630, 0x03);
    lcd_write_reg(0xD631, 0x33);
    lcd_write_reg(0xD632, 0x03);
    lcd_write_reg(0xD633, 0x6D);
    lcd_write_reg(0xF000, 0x55);
    lcd_write_reg(0xF001, 0xAA);
    lcd_write_reg(0xF002, 0x52);
    lcd_write_reg(0xF003, 0x08);
    lcd_write_reg(0xF004, 0x00);
    lcd_write_reg(0xB100, 0xCC);
    lcd_write_reg(0xB101, 0x00);
    lcd_write_reg(0xB600, 0x05);
    lcd_write_reg(0xB700, 0x70);
    lcd_write_reg(0xB701, 0x70);
    lcd_write_reg(0xB800, 0x01);
    lcd_write_reg(0xB801, 0x03);
    lcd_write_reg(0xB802, 0x03);
    lcd_write_reg(0xB803, 0x03);
    lcd_write_reg(0xBC00, 0x02);
    lcd_write_reg(0xBC01, 0x00);
    lcd_write_reg(0xBC02, 0x00);
    lcd_write_reg(0xC900, 0xD0);
    lcd_write_reg(0xC901, 0x02);
    lcd_write_reg(0xC902, 0x50);
    lcd_write_reg(0xC903, 0x50);
    lcd_write_reg(0xC904, 0x50);
    lcd_write_reg(0x3500, 0x00);
    lcd_write_reg(0x3A00, 0x55);
    lcd_wr_regno(0x1100);
    delay_us(120);
    lcd_wr_regno(0x2900);
}

/**
 * @brief       ILI9806寄存器初始化代码 
 * @param       无
 * @retval      无
 */
void lcd_ex_ili9806_reginit(void)
{
    lcd_wr_regno(0xFF);
    lcd_wr_data(0xFF);
    lcd_wr_data(0x98);
    lcd_wr_data(0x06);
    lcd_wr_regno(0xBC);
    lcd_wr_data(0x01);
    lcd_wr_data(0x0F);
    lcd_wr_data(0x61);
    lcd_wr_data(0xFF);
    lcd_wr_data(0x01);
    lcd_wr_data(0x01);
    lcd_wr_data(0x0B);
    lcd_wr_data(0x10);
    lcd_wr_data(0x37);
    lcd_wr_data(0x63);
    lcd_wr_data(0xFF);
    lcd_wr_data(0xFF);
    lcd_wr_data(0x01);
    lcd_wr_data(0x01);
    lcd_wr_data(0x00);
    lcd_wr_data(0x00);
    lcd_wr_data(0xFF);
    lcd_wr_data(0x52);
    lcd_wr_data(0x01);
    lcd_wr_data(0x00);
    lcd_wr_data(0x40);
    lcd_wr_regno(0xBD);
    lcd_wr_data(0x01);
    lcd_wr_data(0x23);
    lcd_wr_data(0x45);
    lcd_wr_data(0x67);
    lcd_wr_data(0x01);
    lcd_wr_data(0x23);
    lcd_wr_data(0x45);
    lcd_wr_data(0x67);
    lcd_wr_regno(0xBE);
    lcd_wr_data(0x00);
    lcd_wr_data(0x01);
    lcd_wr_data(0xAB);
    lcd_wr_data(0x60);
    lcd_wr_data(0x22);
    lcd_wr_data(0x22);
    lcd_wr_data(0x22);
    lcd_wr_data(0x22);
    lcd_wr_data(0x22);
    lcd_wr_regno(0xC7);
    lcd_wr_data(0x36);
    lcd_wr_regno(0xED);
    lcd_wr_data(0x7F);
    lcd_wr_data(0x0F);
    lcd_wr_regno(0XC0);
    lcd_wr_data(0x0F);
    lcd_wr_data(0x0B);
    lcd_wr_data(0x0A);
    lcd_wr_regno(0XFC);
    lcd_wr_data(0x08);
    lcd_wr_regno(0XDF); 
    lcd_wr_data(0x00);
    lcd_wr_data(0x00);
    lcd_wr_data(0x00);
    lcd_wr_data(0x00);
    lcd_wr_data(0x00);
    lcd_wr_data(0x20);
    lcd_wr_regno(0XF3);
    lcd_wr_data(0x74);
    lcd_wr_regno(0xB4);
    lcd_wr_data(0x00);
    lcd_wr_data(0x00);
    lcd_wr_data(0x00);
    lcd_wr_regno(0xF7);
    lcd_wr_data(0x82);
    lcd_wr_regno(0xB1);
    lcd_wr_data(0x00);
    lcd_wr_data(0x13);
    lcd_wr_data(0x13);
    lcd_wr_regno(0XF2);
    lcd_wr_data(0x80);
    lcd_wr_data(0x04);
    lcd_wr_data(0x40);
    lcd_wr_data(0x28);
    lcd_wr_regno(0XC1);
    lcd_wr_data(0x17);
    lcd_wr_data(0x88);
    lcd_wr_data(0x88);
    lcd_wr_data(0x20);
    lcd_wr_regno(0xE0);
    lcd_wr_data(0x00);
    lcd_wr_data(0x0A);
    lcd_wr_data(0x12);
    lcd_wr_data(0x10);
    lcd_wr_data(0x0E);
    lcd_wr_data(0x20);
    lcd_wr_data(0xCC);
    lcd_wr_data(0x07);
    lcd_wr_data(0x06);
    lcd_wr_data(0x0B);
    lcd_wr_data(0x0E);
    lcd_wr_data(0x0F);
    lcd_wr_data(0x0D);
    lcd_wr_data(0x15);
    lcd_wr_data(0x10);
    lcd_wr_data(0x00);
    lcd_wr_regno(0xE1);
    lcd_wr_data(0x00);
    lcd_wr_data(0x0B);
    lcd_wr_data(0x13);
    lcd_wr_data(0x0D);
    lcd_wr_data(0x0E);
    lcd_wr_data(0x1B);
    lcd_wr_data(0x71);
    lcd_wr_data(0x06);
    lcd_wr_data(0x06);
    lcd_wr_data(0x0A);
    lcd_wr_data(0x0F);
    lcd_wr_data(0x0E);
    lcd_wr_data(0x0F);
    lcd_wr_data(0x15);
    lcd_wr_data(0x0C);
    lcd_wr_data(0x00);
    lcd_wr_regno(0x2a);
    lcd_wr_data(0x00);
    lcd_wr_data(0x00);
    lcd_wr_data(0x01);
    lcd_wr_data(0xdf);
    lcd_wr_regno(0x2b);
    lcd_wr_data(0x00);
    lcd_wr_data(0x00);
    lcd_wr_data(0x03);
    lcd_wr_data(0x1f);
    lcd_wr_regno(0x3A);
    lcd_wr_data(0x55);
    lcd_wr_regno(0x36);
    lcd_wr_data(0x00);
    lcd_wr_regno(0x11);
    delay_ms(120);
    lcd_wr_regno(0x29);
    delay_ms(20);
    lcd_wr_regno(0x2C);
}

/**
 * @brief       SSD1963寄存器初始化
 * @param       无
 * @retval      无
 */
void lcd_ex_ssd1963_reginit(void)
{
    lcd_wr_regno(0xE2);
    lcd_wr_data(0x1D);
    lcd_wr_data(0x02);
    lcd_wr_data(0x04);
    delay_us(100);
    lcd_wr_regno(0xE0);
    lcd_wr_data(0x01);
    delay_ms(10);
    lcd_wr_regno(0xE0);
    lcd_wr_data(0x03);
    delay_ms(12);
    lcd_wr_regno(0x01);
    delay_ms(10);
    lcd_wr_regno(0xE6);
    lcd_wr_data(0x2F);
    lcd_wr_data(0xFF);
    lcd_wr_data(0xFF);
    lcd_wr_regno(0xB0);
    lcd_wr_data(0x20);
    lcd_wr_data(0x00);
    lcd_wr_data((SSD_HOR_RESOLUTION - 1) >> 8);
    lcd_wr_data(SSD_HOR_RESOLUTION - 1);
    lcd_wr_data((SSD_VER_RESOLUTION - 1) >> 8);
    lcd_wr_data(SSD_VER_RESOLUTION - 1);
    lcd_wr_data(0x00);
    lcd_wr_regno(0xB4);
    lcd_wr_data((SSD_HT - 1) >> 8);
    lcd_wr_data(SSD_HT - 1);
    lcd_wr_data(SSD_HPS >> 8);
    lcd_wr_data(SSD_HPS);
    lcd_wr_data(SSD_HOR_PULSE_WIDTH - 1);
    lcd_wr_data(0x00);
    lcd_wr_data(0x00);
    lcd_wr_data(0x00);
    lcd_wr_regno(0xB6);
    lcd_wr_data((SSD_VT - 1) >> 8);
    lcd_wr_data(SSD_VT - 1);
    lcd_wr_data(SSD_VPS >> 8);
    lcd_wr_data(SSD_VPS);
    lcd_wr_data(SSD_VER_FRONT_PORCH - 1);
    lcd_wr_data(0x00);
    lcd_wr_data(0x00);
    lcd_wr_regno(0xF0);
    lcd_wr_data(0x03);
    lcd_wr_regno(0x29);
    lcd_wr_regno(0xD0);
    lcd_wr_data(0x00);
    lcd_wr_regno(0xBE);
    lcd_wr_data(0x05);
    lcd_wr_data(0xFE);
    lcd_wr_data(0x01);
    lcd_wr_data(0x00);
    lcd_wr_data(0x00);
    lcd_wr_data(0x00);
    lcd_wr_regno(0xB8);
    lcd_wr_data(0x03);
    lcd_wr_data(0x01);
    lcd_wr_regno(0xBA);
    lcd_wr_data(0x01);
}
