halfmer/XIH6-Thermal-Camera/ESP_UART_Host/ESP_UART/main.cpp

#include <QApplication>
#include "mainwindow.h"

int main(int argc, char *argv[])
{
    QApplication app(argc, argv);
    app.setApplicationName("ESP UART");
    app.setApplicationVersion("0.1.0");

    MainWindow window;
    window.show();

    return app.exec();
}
