halfmer/XIH6-Thermal-Camera/Core/Src/sdmmc.c

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
/* Includes ------------------------------------------------------------------*/
#include "sdmmc.h"

SD_HandleTypeDef hsd2;

/* SDMMC2 init function */

void MX_SDMMC2_SD_Init(void)
{

  /* USER CODE BEGIN SDMMC2_Init 1 */
  /* The full SD bring-up (presence check + clean, non-blocking error handling,
     hot-plug aware) is performed by SD_Card_Init() in the application. Skip
     CubeMX's blocking HAL_SD_Init()/Error_Handler() path below, so the board
     still boots (and can report "No Card") when the slot is empty. GPIO, clock
     and NVIC are configured later by HAL_SD_MspInit(), which HAL_SD_Init()
     invokes from inside SD_Card_Init(). */
  return;
  /* USER CODE END SDMMC2_Init 1 */
  hsd2.Instance = SDMMC2;
  hsd2.Init.ClockEdge = SDMMC_CLOCK_EDGE_RISING;
  hsd2.Init.ClockPowerSave = SDMMC_CLOCK_POWER_SAVE_DISABLE;
  hsd2.Init.BusWide = SDMMC_BUS_WIDE_4B;
  hsd2.Init.HardwareFlowControl = SDMMC_HARDWARE_FLOW_CONTROL_DISABLE;
  hsd2.Init.ClockDiv = 255;
  if (HAL_SD_Init(&hsd2) != HAL_OK)
  {
    Error_Handler();
  }
}

void HAL_SD_MspInit(SD_HandleTypeDef* sdHandle)
{

  GPIO_InitTypeDef GPIO_InitStruct = {0};
  if(sdHandle->Instance==SDMMC2)
  {
    /* SDMMC2 clock enable */
    __HAL_RCC_SDMMC2_CLK_ENABLE();

    __HAL_RCC_GPIOB_CLK_ENABLE();
    __HAL_RCC_GPIOD_CLK_ENABLE();
    /**SDMMC2 GPIO Configuration
    PB4 (NJTRST)     ------> SDMMC2_D3
    PD6     ------> SDMMC2_CK
    PB3 (JTDO/TRACESWO)     ------> SDMMC2_D2
    PD7     ------> SDMMC2_CMD
    PB15     ------> SDMMC2_D1
    PB14     ------> SDMMC2_D0
    */
    GPIO_InitStruct.Pin = GPIO_PIN_4|GPIO_PIN_3|GPIO_PIN_15|GPIO_PIN_14;
    GPIO_InitStruct.Mode = GPIO_MODE_AF_PP;
    GPIO_InitStruct.Pull = GPIO_PULLUP;
    GPIO_InitStruct.Speed = GPIO_SPEED_FREQ_VERY_HIGH;
    GPIO_InitStruct.Alternate = GPIO_AF9_SDIO2;
    HAL_GPIO_Init(GPIOB, &GPIO_InitStruct);

    GPIO_InitStruct.Pin = GPIO_PIN_6;
    GPIO_InitStruct.Mode = GPIO_MODE_AF_PP;
    GPIO_InitStruct.Pull = GPIO_NOPULL;
    GPIO_InitStruct.Speed = GPIO_SPEED_FREQ_VERY_HIGH;
    GPIO_InitStruct.Alternate = GPIO_AF11_SDIO2;
    HAL_GPIO_Init(GPIOD, &GPIO_InitStruct);

    GPIO_InitStruct.Pin = GPIO_PIN_7;
    GPIO_InitStruct.Mode = GPIO_MODE_AF_PP;
    GPIO_InitStruct.Pull = GPIO_PULLUP;
    GPIO_InitStruct.Speed = GPIO_SPEED_FREQ_VERY_HIGH;
    GPIO_InitStruct.Alternate = GPIO_AF11_SDIO2;
    HAL_GPIO_Init(GPIOD, &GPIO_InitStruct);

  /* USER CODE BEGIN SDMMC2_MspInit 1 */
    /* SDMMC2 global interrupt: required for HAL_SD_*Blocks_DMA() completion
       callbacks. STM32H7 SDMMC uses its internal IDMA, whose end-of-transfer
       and error events are reported through SDMMC2_IRQn. */
    HAL_NVIC_SetPriority(SDMMC2_IRQn, 5, 0);
    HAL_NVIC_EnableIRQ(SDMMC2_IRQn);
  /* USER CODE END SDMMC2_MspInit 1 */
  }
}

void HAL_SD_MspDeInit(SD_HandleTypeDef* sdHandle)
{

  if(sdHandle->Instance==SDMMC2)
  {
    /* Peripheral clock disable */
    __HAL_RCC_SDMMC2_CLK_DISABLE();

    /**SDMMC2 GPIO Configuration
    PB4 (NJTRST)     ------> SDMMC2_D3
    PD6     ------> SDMMC2_CK
    PB3 (JTDO/TRACESWO)     ------> SDMMC2_D2
    PD7     ------> SDMMC2_CMD
    PB15     ------> SDMMC2_D1
    PB14     ------> SDMMC2_D0
    */
    HAL_GPIO_DeInit(GPIOB, GPIO_PIN_4|GPIO_PIN_3|GPIO_PIN_15|GPIO_PIN_14);

    HAL_GPIO_DeInit(GPIOD, GPIO_PIN_6|GPIO_PIN_7);

  }
}
