halfmer/XIH6-Thermal-Camera/(commit log)

2026-07-07 初始提交: Step9D 手工恢复现场 (HEX MD5 55B9AED8, 上板启动死机待修)
    - 固件: USART1 1.5M + 8KB TX DMA ring / UART4 1.5M RAW16 DMA ping-pong / span<16 门禁
    - 上板症状: LED 不翻转、USART1 无输出、启动链路死 (README_11 根因分析: 1KB 栈溢出主嫌)
    - 含 Qt 上位机源码 (ESP_UART_Host, 线程化+1.5M)
    - 忽略: FreeRTOS 死重量 196MB / Qt build 359MB / Keil 中间产物 (保留 hex/map/sct)
    [PureThermal_Micro_BoB.step]
2026-07-07 Step A: 栈 1KB→8KB 单变量验证版 (HEX MD5 F0304834)
    - 唯一改动 startup_stm32h743xx.s Stack_Size 0x400→0x2000
    - Code=85406 与死机版一致(代码零变化), ZI +7168B=栈扩量, 其余对象地址不变
    - 验证目标: 若启动恢复 → README_11 §4 栈溢出根因坐实
    - README_11 补执行记录 §7
2026-07-07 对齐 _1FPS 金标准复现点 (HEX MD5 315D8DC9, 与金标准逐字节一致)
    - 9 文件对齐 XIH6_V3_1FPS 快照: main.c/usart.c/dma.c/it.c/it.h/lepton_stream.c/h/lepton.c 注释/ioc
    - USART1 回 115200 阻塞, UART4 1.5M 阻塞单缓冲, 无 DMA ring/门禁/诊断计时
    - 等价证明: Stack=0x400 时构建 MD5=315D8DC9F8655E420457AB7A0DB2A698 == _1FPS 产物
    - 用户确认: 前期 no frame/启动怪象部分为硬件接线问题, 已修复
    [XIH6_V2.ioc, lepton.c, lepton_stream.c, lepton_stream.h, main.c]
2026-07-07 基线+8KB栈 (HEX MD5 90AF7930) — 后续优化的起点
    - 唯一 delta vs 金标准 = Stack 0x400→0x2000 (防 DMA 中断链/大缓冲栈溢出复发, README_11 §4)
    - Code/RO/RW 与金标准一致, ZI +7168B=栈扩量
2026-07-07 优化Step1: UART4 TX DMA + Ping-Pong (HEX MD5 8088DB79)
    - 复刻 README_8 Step3 双缓冲结构: DMA1_Stream1, 32B 对齐 stride, busy 即丢帧不阻塞采集
    - 内置 README_9 Step9A 教训: 成功路径/busy drop 零打印, [STRM] 仅 DMA 启动失败时输出
    - 基于 _1FPS 干净基线 + 8KB 栈; USART1 保持 115200 阻塞, main.c 零改动
    - 预期: 采集不再被 256ms 阻塞发送卡住, ~2FPS; 验证点 checksum_bad=0
2026-07-07 README_12: 基线固化与优化 Step1 记录
2026-07-07 Qt撕裂帧门禁: 整帧原子显示, 拒绝跨时间拼接帧 (esp_uart 9C0A77EC)
    - 新增 framegate.h/cpp: 检测 30/60/90 行 segment 边界的行差跳变 vs 帧内中位基线
    (STM32 persistent shelf 允许 4 段来自不同采集轮次, 运动场景呈横向割裂)
    - ThermalWidget::displayFrame 改 bool: 撕裂帧不上屏保持上一帧, 连拒 5 帧强制放行防冻结
    - MainWindow: frame_torn 写 serial_diag.log, 状态栏加撕裂拒显计数
    - selftest 新增 5 用例(平滑放行/双边界拦截/非边界边缘不误杀/报告字段), 全过 exit=0
    - deploy 同步待用户关闭运行中的 esp_uart.exe (build_qt_fix 已是新版)
2026-07-07 README_12 §4: Qt 撕裂门禁记录
2026-07-07 优化Step2: VoSPI fresh-generation 发布门禁 (HEX MD5 0E080167)
    - 运动掉帧根因: persistent shelf 每逢 seg4 即发布, 丢段轮次发布跨时间拼接帧;
    静止时拼接不可见, 运动时全被 Qt 撕裂门禁拦截 → 显示 FPS 2→~0.33 (连拒5放1)
    - 修复: 段号回卷/Resync 时 generation++, commit 记录 seg_gen[seg];
    发布加条件 4 段同代, 不同代计 vospi_stale_block 并继续采集
    - 与当年失败的 fresh_mask 区别: 不清 mask/不要求包级连续; 接线修复后 badseg 已大降
    - 编译开关 LEPTON_VOSPI_FRESH_PUBLISH=0 可一键回退旧语义
    - [LEP] VoSPI 诊断行新增 stale=N 字段; CH340 链路无责(数据量与画面内容无关)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
    [lepton.c, lepton.h, main.c]
2026-07-08 修复fresh门禁no frame: 段内discard≠desync(重试环)+stale防饿死 (HEX MD5 B94FCF90)
    根因: Lepton_Capture_Frame 60包循环把段内discard包判为desync整段作废,
    而段内discard是主机读快于包生成(~440us/包)的正常流控现象。
    fresh-generation 门禁要求连续4段同代成功, 段成功率p下降后 p^4 崩塌
    → guard 耗尽 → 长期 no frame。同机制解释当年 fresh_mask 失败真因。
    修复(单变量原则内的一组配套改动):
    1. 段内 discard 重试环: discard 包 HAL_Delay(1) 重读同包, 上限
    LEPTON_VOSPI_INTRA_DISCARD_MAX=8 次, 超限才按 desync 处理
    2. stale 防饿死: 单次 capture 内 fresh 拦截达
    LEPTON_VOSPI_S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
    [lepton.c]
2026-07-08 README_12 §5: no frame 根因(段内discard≠desync)与修复记录
2026-07-08 修复no frame真根因: seg=0哑段按规范静默跳过 + 防饿死改跨capture持久计数 (HEX MD5 4B1A9582)
    实测诊断(uart_noframe_B94FCF90.log): pkt0=52 中 bad0=38(73%)——
    Lepton3.5 内部26Hz/导出8.7Hz, 每3个帧槽2个为 seg=0 哑段, 属正常流。
    旧代码把哑段当 bad_seg 失败: HAL_Delay(1)+重猎pkt0, 打断包级同步,
    致后续真段大量 desync(14真段仅~3完成), seg4 几乎从不完成→永不发布。
    同时 stale 防饿死计数被每 capture DiagReset 清零, 而 seg4 每 capture
    最多完成1次, 阈值4永不可达→防饿死失效。
    修复: ①seg=0 时仅计 bad0, 继续读完60包不 fail 不延时(规范行为);
    ②新增跨 capture 静态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
    [lepton.c]
2026-07-08 README_12 §5.5: no frame 真根因(seg=0哑段)实测判读与修复记录
2026-07-08 回退: lepton.c 采集路径整体恢复 2FPS 金标准 (HEX MD5 C87FBCC8)
    实测判决(uart_4B1A9582.log): 哑段修复版 desync=25~27, 失败点 exp=46
    段中部, 收包号跳变——段内 discard 重试环的 HAL_Delay(1)xN 累积延时
    超过 Lepton 段窗口, 传感器跳段, 比 2FPS 版(对段内 discard 立即放弃
    重猎)更差。fresh 门禁两轮修补均引入新问题, 按单变量红线整体回退。
    diff 定责: lepton_stream.c/h 与 2FPS 快照逐字节一致, main.c 仅诊断
    打印差异——上位机与传输协议无改动, no frame 全部源于 lepton.c 采集
    路径的 Step2 改动。运动割裂交由 Qt 撕裂门禁(b3f4c47)处理。
    lepton.h 保留 vospi_stal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
    [lepton.c]
2026-07-08 README_12 §5.6: fresh门禁回退判决与教训
2026-07-08 双链路切换+ESP32桥+协作时间轮+MQ火灾预警ppm量化 (HEX MD5 567EF0AA)
    README_13: UART4/SPI5 运行时双链路(帧边界切换,不abort在飞DMA), MODE_*/单字节
    双命令, USART1 change over/ok, PG2就绪线(AUTO_TCP默认关), PJ7开漏30s烧录窗口;
    ESP32-S3 生产者-消费者双任务桥(SPI主机10MHz+CS硬件NSS+DRDY中断+3缓冲队列);
    Qt 切换传输模式按钮(MODE_TOGGLE)+WiFi模式串口文本隔离。
    README_14: 主循环协作时间轮(视频不进轮每轮先跑, 背景任务表驱动200ms/500ms/
    1s/2s门控); 新模块 Drivers/PER/FIRE fire_guard: MQ-2(PA1_C/ADC1)+MQ-135
    (PA0_C/ADC2) ppm量化(Rs=RL(Vc-Vout)/Vout, ppm=A*(Rs/R0)^B), WARMUP60s->
    CALIB洁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
2026-07-08 MQ135改走ADC1双通道+启动ADC自检+RGB灯阈值G>4ppm (HEX MD5 6091ACF1)
    A恒0定责: PA0_C/PA1_C(INP0/INP1)是ADC1/ADC2共享直连通道, 实测ADC1好用
    ADC2恒0 -> 两路统一走ADC1, 每次采样前切通道(µs级), ADC2整体旁路。
    FireGuard_Init 增加启动自检打印([FIRE] adc1 selftest raw/st), 下次日志
    可一锤定音区分配置问题与接线问题; 转换OK但引脚~0V时提示查AO接线/5V供电。
    阈值: MQ-2 >4ppm 亮RGB灯(PJ15), <3ppm 灭(洁净空气基线~3.6ppm, 极灵敏)。
    [fire_guard.c, fire_guard.h]
2026-07-09 SHT40非阻塞+ADC原生通道+Qt撕裂帧段缓存重组+百分位色图 (HEX MD5 160CD0F1)
    STM32: SHT40非阻塞两段式(10ms分散到~90轮迭代,不阻塞VoSPI);
    ADC恢复ADC1/ADC2原生通道+810.5周期+自检打印定位A=0。
    Qt: 撕裂帧段缓存重组(不丢弃,每段更新拼帧显示,延迟<1s);
    colormap百分位p2/p98归一化(抗离群像素,26C不再粉红);
    selftest适配,全通过。
2026-07-09 同帧装配消撕裂+死像素插值+AGC关闭+色图过滤0/0xFFFF+OLED双raw显示 (HEX MD5 f9b072404949867e0cd4aa88cb8e9c08)
    lepton.c: frame_seg_mask 同帧装配(seg1=帧边界,丢段即丢帧,不再跨帧缝合);
    Lepton_Assembly_DeadPixelFix 4邻域均值替换0/0xFFFF(STM32图像处理,不破坏温度);
    Lepton_Init 显式 Lepton_SetAGC(0)(AGC工厂默认ON压扁动态范围致火焰读近环境温)
    colormap.cpp: 过滤0/0xFFFF后再p2/p98(火焰像素排除后经qBound钳LUT顶端,不再粉红/截断)
    main.c: App_Task_Oled 显 g%5u %3up a%5u %3up(raw+ppm双传感器,A=0/G不动现场可判)
    README_14 §9: 四条上板反馈逐条归因与修复记录
    [colormap.cpp, lepton.c, lepton.h, main.c]
2026-07-09 Revert "同帧装配消撕裂+死像素插值+AGC关闭+色图过滤0/0xFFFF+OLED双raw显示 (HEX MD5 f9b072404949867e0cd4aa88cb8e9c08)"
    This reverts commit 2864b27d8187473a13cb76c052c55c0283e4db94.
    [colormap.cpp, lepton.c, lepton.h, main.c]
2026-07-09 封箱提交: 两周从零到完整热成像系统——所有源码/文档/实物图/APK/PCB 归档
    终态基线: dbb4133 / HEX MD5 160CD0F1
    - STM32H743 裸机固件: VoSPI 帧采集 + 协作时间轮 + MQ ppm 火灾预警 + LEPTON 过温报警
    - Qt6 桌面端: 串口/WiFi 双模式，零撕裂，百分位色图
    - Android 客户端: Kotlin + Material3, AA55 协议兼容, v1.0 已编译
    - ESP32-S3 桥: SPI 主机拉流 + TCP 透传, DRDY 握手
    - PCB 立创EDA 工程
    - 实物照片 6 张 + 开发日志 README_2~15 (13篇)
    - APK 安装包
    已知边界: CCI 硬件未通, ~2FPS, Android 端到端联调未完成
2026-07-09 README 重构: 图文对位修正+架构/协议/引脚/日志导航全补齐; 移除 AGENTS/CLAUDE 内部配置文件
    - 修正图片配文(003 是 3D 打印外壳非串口 shell; 005 补撕裂拒显 353 实测解说)
    - 按 成品→实测→架构→协议→硬件→软件→上手→日志 叙事链重排
    - 新增: AA55 帧格式字节表、控制命令表、LEPTON/ESP32 引脚连接表、
    14 篇开发日志导航、硬件清单、帧数据流水线图
    - AGENTS.md/CLAUDE.md 为 AI 协作内部配置, 移出仓库(本地保留)
2026-07-10 新添加感谢环节
