halfmer/XIH6-Thermal-Camera/(notices)

Notices in the files:
Drivers/PER/LCD/ltdc.c:
@license Copyright (c) 2020-2032, ¹ãÖÝÊÐÐÇÒíµç×Ó¿Æ¼¼ÓÐÏÞ¹«Ë¾
Core/Src/sdmmc.c:
Copyright (c) 2026 STMicroelectronics.
All rights reserved.
This software is licensed under terms that can be found in the LICENSE file
